evanpurkhiser/DW-SNS-01/firmware/src/app_config.h

#ifndef APP_CONFIG_H
#define APP_CONFIG_H

#include "app_build_config.h"

// D9 (PA4) powers the LDR; D8 (PA3) reads the LDR/10k divider midpoint.
#define APP_SENSOR_POWER_PORT gpioPortA
#define APP_SENSOR_POWER_PIN 4U
#define APP_SENSOR_INPUT_PORT gpioPortA
#define APP_SENSOR_INPUT_PIN 3U
#define APP_SENSOR_INPUT iadcPosInputPortAPin3

// The onboard divider exposes half of VBAT on PD4 while PD3 is high.
#define APP_BATTERY_ENABLE_PORT gpioPortD
#define APP_BATTERY_ENABLE_PIN 3U
#define APP_BATTERY_INPUT_PORT gpioPortD
#define APP_BATTERY_INPUT_PIN 4U
#define APP_BATTERY_INPUT iadcPosInputPortDPin4
#define APP_BATTERY_SETTLE_US 1000U

// Select the XIAO's built-in ceramic antenna. The RAIL RF path switch
// component gates the switch's PB5 power input with radio activity.
#define APP_RF_SWITCH_SELECT_PORT gpioPortB
#define APP_RF_SWITCH_SELECT_PIN 4U

#define APP_PAIRING_LED_PORT gpioPortA
#define APP_PAIRING_LED_PIN 7U
#define APP_PAIRING_LED_BLINK_MS 500U
#define APP_CONNECTED_LED_DURATION_MS 2000U

#define APP_SENSOR_ON_MV 800U
#define APP_SENSOR_OFF_MV 600U
#define APP_SENSOR_SETTLE_US 100U
#define APP_REQUIRED_STABLE_SAMPLES 2U
#define APP_SAMPLE_INTERVAL_MS 10000U
#define APP_JOIN_RETRY_INTERVAL_MS 5000U
#define APP_CONNECTION_TIMEOUT_MS 120000U
#define APP_BATTERY_REPORT_INTERVAL_MS (12UL * 60UL * 60UL * 1000UL)
#define APP_BATTERY_REPORT_RETRY_MS (5UL * 60UL * 1000UL)
#define APP_BATTERY_REPORT_MAX_RETRIES 3U
#if APP_DEBUG_BUILD
#define APP_RADIO_TX_POWER_DBM 19
#else
#define APP_RADIO_TX_POWER_DBM 8
#endif

#define APP_ENDPOINT 1U
#define APP_COORDINATOR_ENDPOINT 1U

#endif
