evanpurkhiser/DW-SNS-01/(commit log)

2026-09-05 Add Zigbee battery reporting
2026-09-05 Bound battery report retries
2026-09-06 Move light sensor input to D8
2026-09-06 Fix Zigbee battery discovery
    [app.c]
2026-09-09 Reduce firmware idle power
    Separate diagnostic and production behavior so deployed sensors can enter the lowest practical sleep state. Gate the XIAO RF switch from radio activity, shut down the correctly wired onboard flash, and reduce routine Zigbee radio use while retaining a diagnostic build for hardware validation.
    [app.c, app_config.h, end-device-support-config.h, sl_board_control_config.h]
